Smart-Cushion/FSR_matrix_readout/(commit log)

2026-06-07 finished selecting most of the chips, did some initial works
    [16_to_1_decoder.kicad_sch, FSR_matrix_readout.kicad_pcb, FSR_matrix_readout.kicad_sch, frontend_mux.kicad_sch]
2026-06-08 done sense opamp module
    [16_to_1_decoder.kicad_sch, FSR_matrix_readout.kicad_sch, Molex_502250-1791_2Rows-17Pins-1MP_P0.60mm_Horizontal.step, Molex_502250-2191_2Rows-21Pins-1MP_P0.60mm_Horizontal.step, Molex_502250-2391_2Rows-23Pins-1MP_P0.60mm_Horizontal.step, Molex_502250-2791_2Rows-27Pins-1MP_P0.60mm_Horizontal.step, Molex_502250-3391_2Rows-33Pins-1MP_P0.60mm_Horizontal.step, Molex_502250-3591_2Rows-35Pins-1MP_P0.60mm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]
2026-06-08 add feedback cap for TIA opamp
    [sense_opamps.kicad_sch]
2026-06-08 add addr_counter
    [FSR_matrix_readout.kicad_sch, addr_counter.kicad_sch]
2026-06-08 update connection
    [FSR_matrix_readout.kicad_sch, addr_counter.kicad_sch]
2026-06-08 done backend_mux; cleanup connection; start dynamic gain opamp
    [FSR_matrix_readout.kicad_sch, backend_mux.kicad_sch, dynamic_gain_opamp.kicad_sch]
2026-06-09 done PGA and ADC
    [FSR_matrix_readout.kicad_sch, adc.kicad_sch, dynamic_gain_opamp.kicad_sch, sense_opamps.kicad_sch]
2026-06-09 done everything except MCU
    [FSR_matrix_readout.kicad_sch, adc.kicad_sch, addr_counter.kicad_sch, power.kicad_sch]
2026-06-09 add decoupling cap for Vg in sense_opamps
    [adc.kicad_sch, power.kicad_sch, sense_opamps.kicad_sch]
2026-06-09 fix Vg-related issuies
    [FSR_matrix_readout.kicad_sch, adc.kicad_sch, dynamic_gain_opamp.kicad_sch, power.kicad_sch]
2026-06-11 add esp devboard module and finished connection
    [FSR_matrix_readout.kicad_sch, addr_counter.kicad_sch, dynamic_gain_opamp.kicad_sch, freenove_esp32s3_dev.kicad_sch, power.kicad_sch]
2026-06-11 remove all ERC errors
    [16_to_1_decoder.kicad_sch, FSR_matrix_readout.kicad_sch, addr_counter.kicad_sch, freenove_esp32s3_dev.kicad_sch, frontend_mux.kicad_sch, sense_opamps.kicad_sch]
2026-06-11 fixed all non-footprint ERC
    [16_to_1_decoder.kicad_sch, FSR_matrix_readout.kicad_sch, adc.kicad_sch, addr_counter.kicad_sch, backend_mux.kicad_sch, dynamic_gain_opamp.kicad_sch, freenove_esp32s3_dev.kicad_sch, frontend_mux.kicad_sch]
2026-06-11 fix vref issue for GPA
    [dynamic_gain_opamp.kicad_sch]
2026-06-11 add dual feedback for Vg opamp
    [frontend_mux.kicad_sch, power.kicad_sch]
2026-06-11 added some test points
    [FSR_matrix_readout.kicad_sch, dynamic_gain_opamp.kicad_sch, frontend_mux.kicad_sch, power.kicad_sch, sense_opamps.kicad_sch]
2026-06-12 renmaing and cleanup
    [16_to_1_decoder.kicad_sch, FSR_matrix_readout.kicad_pcb, FSR_matrix_readout.kicad_sch, adc.kicad_sch, addr_counter.kicad_sch, backend_mux.kicad_sch, freenove_esp32s3_dev_board.kicad_sch, frontend_analog_switch.kicad_sch]
2026-06-12 capitalize netnames; change and embed font
    [16_to_1_decoder.kicad_sch, FSR_matrix_readout.kicad_sch, adc.kicad_sch, addr_counter.kicad_sch, backend_mux.kicad_sch, freenove_esp32s3_dev_board.kicad_sch, frontend_analog_switch.kicad_sch, power.kicad_sch]
2026-06-12 adjust subsheet appearance
    [FSR_matrix_readout.kicad_sch]
2026-06-12 add internal adc proj and renmae
    [16_to_1_decoder.kicad_sch, FSR_matrix_readout.kicad_pcb, FSR_matrix_readout.kicad_sch, adc.kicad_sch, addr_counter.kicad_sch, backend_mux.kicad_sch, freenove_esp32s3_dev_board.kicad_sch, frontend_analog_switch.kicad_sch]
2026-06-12 add internal adc proj and rename
    [16_to_1 Decoder.kicad_sch, 16x Frontend Analog Switch.kicad_sch, 16x TIA Op-amps.kicad_sch, 3V3 And 1V65 Power.kicad_sch, fsr_matrix_readout_external_adc.kicad_pcb, fsr_matrix_readout_external_adc.kicad_sch, fsr_matrix_readout_internal_adc.kicad_pcb, fsr_matrix_readout_internal_adc.kicad_sch]
2026-06-12 relocate lcsc_parts and chamge symbol and footprint tables
2026-06-12 done schematics for internal ADC version
    [16x Frontend Analog Switch.kicad_sch, 16x_tia_opamps.kicad_sch, 3V3 And 1V65 Power.kicad_sch, 4_to_16 Decoder.kicad_sch, 4_to_16_decoder.kicad_sch, esp32_s3_devkit_1.kicad_sch, fsr_matrix_readout_external_adc.kicad_sch, fsr_matrix_readout_internal_adc.kicad_pcb]
2026-06-12 adjust VG issue for internal ADC version; changed naming for VG
    [16x Frontend Analog Switch.kicad_sch, 16x TIA Op-amps.kicad_sch, 16x_tia_opamps.kicad_sch, 3V3 And 1V65 Power.kicad_sch, 4_to_16_decoder.kicad_sch, frontend_analog_switch.kicad_sch, fsr_matrix_readout_external_adc.kicad_sch, fsr_matrix_readout_internal_adc.kicad_sch]
2026-06-13 add testpoint for internal ADC ver
    [fsr_matrix_readout_internal_adc.kicad_sch]
2026-06-13 update pcb for internal adc version
    [16x Frontend Analog Switch.kicad_sch, 16x_tia_opamps.kicad_sch, 4_to_16_decoder.kicad_sch, fsr_matrix_readout_internal_adc.kicad_pcb, fsr_matrix_readout_internal_adc.kicad_sch, power.kicad_sch]
2026-06-13 done 3 opamp pcb layout
    [fsr_matrix_readout_internal_adc.kicad_pcb]
2026-06-13 update internal ADC ver PCB
    [fsr_matrix_readout_internal_adc.kicad_pcb]
2026-06-13 done all 4 TIA opamps for internal adc version
    [16x Frontend Analog Switch.kicad_sch, 16x_tia_opamps.kicad_sch, 4_to_16_decoder.kicad_sch, esp32_s3_devkit_1.kicad_sch, fsr_matrix_readout_internal_adc.kicad_pcb, fsr_matrix_readout_internal_adc.kicad_sch, power.kicad_sch]
2026-06-15 fixing all ERC errors for internal ADC ver, fixing warnings now
    [16x Frontend Analog Switch.kicad_sch, 16x_tia_opamps.kicad_sch, 4_to_16_decoder.kicad_sch, esp32_s3_devkit_1.kicad_sch, fsr_matrix_readout_internal_adc.kicad_pcb, fsr_matrix_readout_internal_adc.kicad_sch]
2026-06-15 change ESP connector from pin to socket
    [esp32_s3_devkit_1.kicad_sch, fsr_matrix_readout_internal_adc.kicad_pcb]
2026-06-15 resolving DRC warnings for internal adc ver
    [fsr_matrix_readout_internal_adc.kicad_pcb]
2026-06-15 add teardrop
    [fsr_matrix_readout_internal_adc.kicad_pcb]
2026-06-15 add fab files; add silkscreen for ver and author
    [fsr_matrix_readout_internal_adc-B_Cu.gbr, fsr_matrix_readout_internal_adc-B_Mask.gbr, fsr_matrix_readout_internal_adc-B_Paste.gbr, fsr_matrix_readout_internal_adc-B_Silkscreen.gbr, fsr_matrix_readout_internal_adc-Edge_Cuts.gbr, fsr_matrix_readout_internal_adc-F_Cu.gbr, fsr_matrix_readout_internal_adc-F_Mask.gbr, fsr_matrix_readout_internal_adc-F_Paste.gbr]
2026-06-15 adjust for production
    [fsr_matrix_readout_internal_adc-B_Silkscreen.gbr, fsr_matrix_readout_internal_adc-CuBottom.gbr, fsr_matrix_readout_internal_adc-CuTop.gbr, fsr_matrix_readout_internal_adc-EdgeCuts.gbr, fsr_matrix_readout_internal_adc-F_Cu.gbr, fsr_matrix_readout_internal_adc-MaskBottom.gbr, fsr_matrix_readout_internal_adc-MaskTop.gbr, fsr_matrix_readout_internal_adc-NPTH.drl]
2026-06-16 update BOM
    [fsr_matrix_readout_internal_adc-CuBottom.gbr, fsr_matrix_readout_internal_adc-CuTop.gbr, fsr_matrix_readout_internal_adc-EdgeCuts.gbr, fsr_matrix_readout_internal_adc-MaskBottom.gbr, fsr_matrix_readout_internal_adc-MaskTop.gbr, fsr_matrix_readout_internal_adc-NPTH.drl, fsr_matrix_readout_internal_adc-PTH.drl, fsr_matrix_readout_internal_adc-PasteBottom.gbr]
2026-06-16 add BOM and CPL
    [BOM-fsr_matrix_readout_internal_adc.csv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]
2026-06-17 update file structure for firmware
    [16x Frontend Analog Switch.kicad_sch, 16x_tia_opamps.kicad_sch, 4_to_16_decoder.kicad_sch, BOM-fsr_matrix_readout_internal_adc.csv, adc.kicad_sch, addr_counter.kicad_sch, backend_mux.kicad_sch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]
2026-06-18 done initial firmware for internal adc ver; CI to be added
2026-06-19 fix stack overflow bug and changed sdkconfig so that system output through usb-jtag
    [sense.c]
2026-06-20 remove cont. adc example
2026-06-20 add readme for internal adc firmware
2026-06-20 remove uncessary fields in wiresens config file
2026-06-21 fix decoder pin assignment
    [pin_defs.h]
2026-06-21 fix timeout calculation issue
    [sense.c]
2026-06-22 supports transfer data stream through usb/jtag, not only uart bridge
2026-06-22 update readme, fix bug when in UART transport mode, change default wiresens transport to UART in kconfig
    [wiresens.c]
